HAW-MT-Jg2013/HAW_W15-MD_Team1/(threads)

Thread 10 (2015-10-26):

Turm 2 hat Zeitversatz nach hinten

jbeyerstedt, 2015-10-26:
Turm 2 läuft zwar synchron, die erste LED hat aber einen Versatz von ca. einer halben LED-Zeit. Darum sind die Winkel von Turm 2 immer zu groß!
Außerdem ergibt sich das Problem, dass die letzte LED von Turm 2 zwar erkannt wird, vom Empfänger aber dem Turm 3 (-89°) zugeordnet wird, was die Messung natürlich erheblich verfälscht.

Closed 2015-12-04.
