HAW-MT-Jg2013/HAW_W15-MD_Team1/VOR_receiver/VOR_rx-firmware/towers.h

// Mechatronisches Design - BYR - WS 2015 -- Semesterprojekt
// VOR receiver
// License: GNU GPL v2

#ifndef TOWERS_H
#define TOWERS_H

#include "Arduino.h"

// definitions:
// Tower 1: top left  - 90-180° (Hardware No. B)
// Tower 2: top right - 180°-270° (Hardware No. C)
// Tower 3: bottom    - 0-90° and 270-360° (Hardware No. A)

class Tower {
    int id;
    float pos_x, pos_y;
    boolean has_newData;
    int angleSum;
    unsigned int angleCounter;

    static unsigned int newValuesCounter; // sum off all new data

  public:
    Tower(int id, float pos_x, float pos_y);
    void set_angle(int angle); // degrees
    boolean has_newValue();
    void get_parameters(float* m_param, float* b_param, int* angle);

    static int get_newValuesCounter();
};

#endif /* TOWERS_H */
