HAW-MT-Jg2013/HAW_W15-MD_Team1/(commit log)

2015-09-23 big switch to small function
2015-09-25 Doku die Erste
2015-09-28 VOR Sender funktionieren. fix #1, fix #2, fix #3
    [VOR_tx-firmware.ino]
2015-09-28 Revert "big switch to small function"
    This reverts commit 01afceab9a6a787490bf012cf7fae5166355006a.
    [VOR_tx-firmware.ino]
2015-09-28 mehr Doku und TODOs zum abarbeiten
2015-10-03 wieder ein bisschen aufräumen
    Firmware der alten Teams verschieben, komplett neu schreiben
2015-10-03 DOKU: Positionsalgorithmus berichtigen und ergänzen
2015-10-03 Sender: kleinen Syntaxfehler behoben
    [VOR_tx-firmware.ino]
2015-10-23 div Fehlerbehebungen und debug-Ergänzungen
2015-10-23 Positionswerte über 5 Werte mitten, sodass Datenrate von 2Hz
2015-10-26 schnellere Abfrage der IR-LEDs - Register direkt lesen
2015-11-13 code refactoring, mehr und sinnvollere Kommentare
2015-12-04 fix: sende binäre Daten in cm und nicht meter. Faktor 100 fehlte.
    [VOR_rx-firmware.ino]
2015-12-11 Filterung von Ausreißern
2015-12-11 Filterung von Ausreißern: rücksetzen bei zu vielen Fehlern
2015-12-11 Filterung von Ausreißern: letze Anpassungen und Bugfix
    [VOR_rx-firmware.ino]
2015-12-12 BUGFIX: Parallelendetektion: abs() an der falschen Stelle & korrekte Türme verwenden!
    [VOR_rx-firmware.ino]
2015-12-12 BUGFIX: Geradenschnittpunkt jetzt auch richtig berechnet
    [VOR_rx-firmware.ino]
2015-12-12 Filter von Ausreißern: besseres filterArray
2015-12-12 FIREFIX: Parallelen-Detektion noch weiter korrigieren
    [VOR_rx-firmware.ino]
2015-12-13 FIX: X-Position skalieren, sodass Randwerte auch erreicht werden
    [VOR_rx-firmware.ino]
